mbmorrissey/cadalogger/images/IMG_1785.jpg

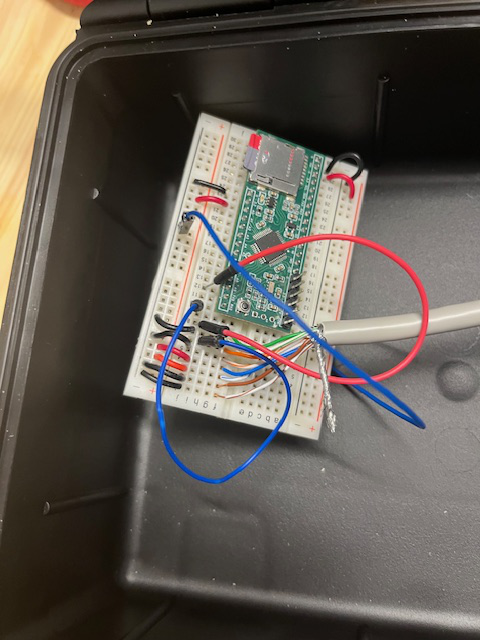
images/IMG_1785.jpg
