mbmorrissey/cadalogger/images/IMG_1795.jpg

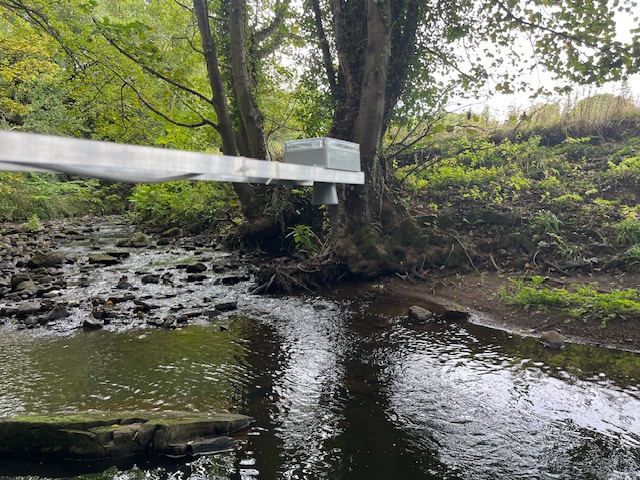
images/IMG_1795.jpg
