mbmorrissey/cadalogger/images/IMG_1796.jpg

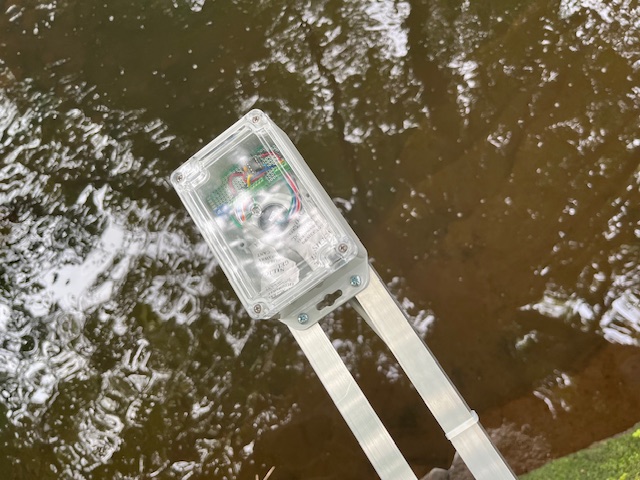
images/IMG_1796.jpg
