mbmorrissey/cadalogger/images/IMG_1797.jpg

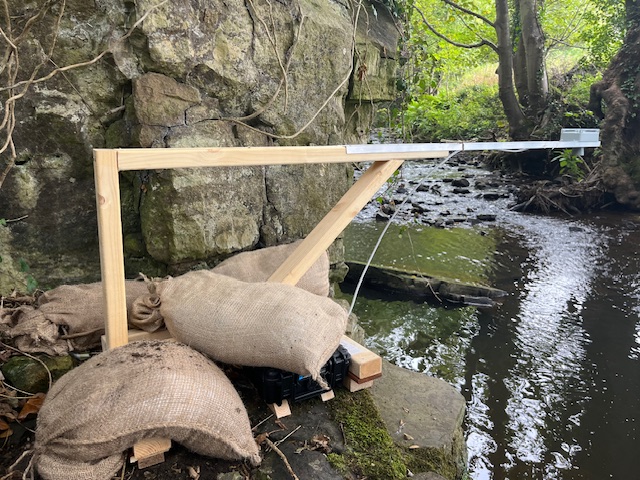
images/IMG_1797.jpg
