mbmorrissey/cadalogger/images/IMG_1801.jpg

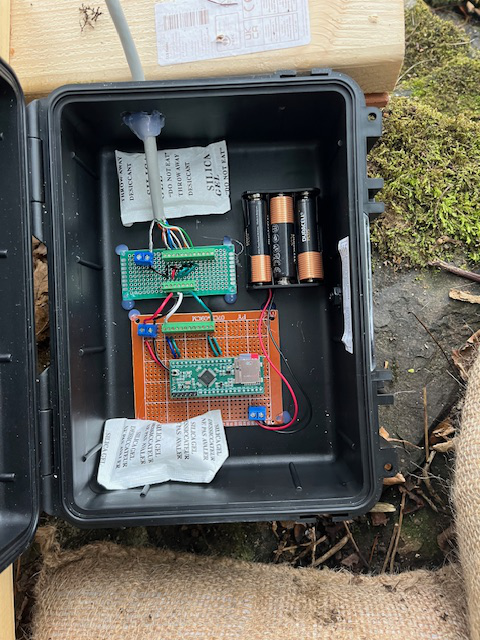
images/IMG_1801.jpg
