mbmorrissey/cadalogger/images/MINI_pinout.png

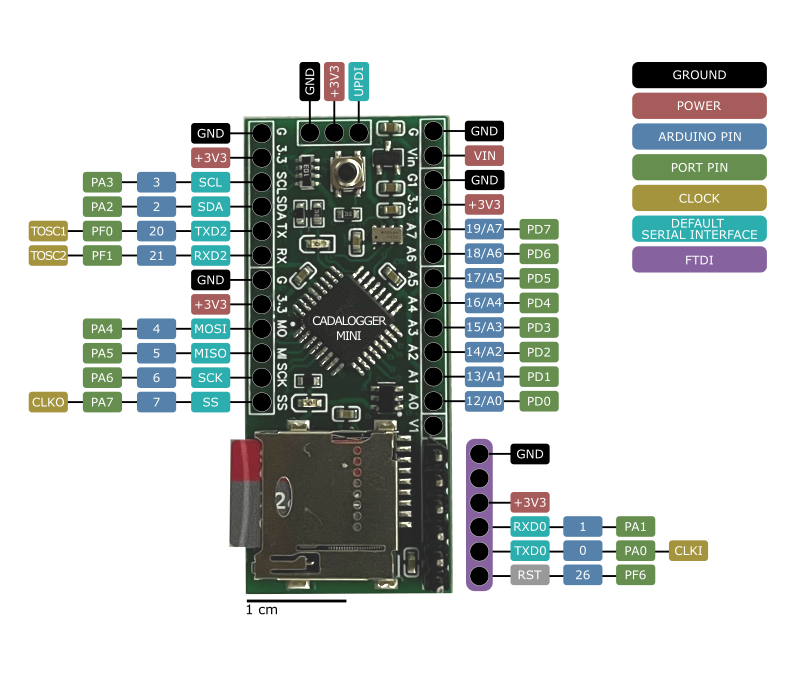
images/MINI_pinout.png
