mbmorrissey/cadalogger/hardware/cadalogger_BOM.xlsx

Sheet: MINI
Item number | Item (short) | Notes | Item (detail) | Manufacturer | Manufacturer part number | Digikey part number | Count | unit cost | quantity for unit cost | total cost per board | quantity for unit cost enough for this many boards | order cost | quantity on hand | on hand sufficient for X boards | Item (copied from column B)
1 | MCU |  | ATMega4808, 32 pin | Microchip | ATMEGA4808-AUR | 150-ATMEGA4808-AURCT-ND | 1 | 1.1968 | 100 | 1.1968 | 100 | 119.68 | 9 | 9 | MCU
2 | RTC |  | RV-3032 | Micro Crystal AG | RV-3032-C7-32.768KHZ-2.5PPM-TA-QC | 2195-RV-3032-C7-32.768KHZ-2.5PPM-TA-QCCT-ND | 1 | 2.6556 | 100 | 2.6556 | 100 | 265.56 | 29 | 29 | RTC
3 | voltage regulator |  | MCP1700, 3.3V | Microchip | MCP1700T-3302E/TT | MCP1700T3302ETTCT-ND | 1 | 0.2984 | 100 | 0.2984 | 100 | 29.84 | 90 | 90 | voltage regulator
4 | uSD clip | Also used in alternate design | MEM2075 | GCT | MEM2075-00-140-01-A | 2073-MEM2075-00-140-01-ACT-ND | 1 | 1.2402 | 100 | 1.2402 | 100 | 124.02 | 60 | 60 | uSD clip
5 | button cell clip |  | 3000TR | Keystone Electronics | 3000TR | 36-3000CT-ND | 1 | 0.5099 | 100 | 0.5099 | 100 | 50.99 | 12 | 12 | button cell clip
6 | switch MOSFET |  | SI2312 | Vishay | SI2312BDS-T1-E3 | SI2312BDS-T1-E3CT-ND | 1 | 0.2947 | 100 | 0.2947 | 100 | 29.47 | 29 | 29 | switch MOSFET
7 | reset switch |  | low profile momentary push button | CIT Relay and Switch | CS1210F260 | 2449-CS1210F260CT-ND | 1 | 0.2932 | 100 | 0.2932 | 100 | 29.32 | 7 | 7 | reset switch
8 | LED | green good for brightness in sunlight |  | SunLED | XZVG53W-8 | 1497-1215-1-ND | 2 | 0.08972 | 500 | 0.17944 | 250 | 44.86 | 160 | 80 | LED
9 | LED resistor | 500R good power-brightness trade-off for green LED | 510R SMD 0603 | Vishay | RCS0603510KFKEA | 41-RCS0603510KFKEACT-ND | 2 | 0.01673 | 1000 | 0.03346 | 500 | 16.73 | 260 | 130 | LED resistor
10 | 10k resistor |  | 10k SMD 0603 | Stackpole | RNCP0603FTD10K0 | RNCP0603FTD10K0CT-ND | 2 | 0.00898 | 1000 | 0.01796 | 500 | 8.98 | 900 | 450 | 10k resistor
11 | 100R resistor |  | 100R SMD 0603 | Stackpole | RMCF0603FT100R | RMCF0603FT100RCT-ND | 1 | 0.0051 | 100 | 0.0051 | 100 | 0.51 | 0 | 0 | 100R resistor
12 | 1 uF capacitor |  | capacitor for voltage regulator | Vishay | VJ0603Y105KXJPW1BC | 720-VJ0603Y105KXJPW1BCCT-ND | 2 | 0.04722 | 500 | 0.09444 | 250 | 23.61 | 80 | 40 | 1 uF capacitor
13 | 0.1 uF capacitor |  | bypass resistors for V pins | Vishay | VJ0603Y104KXXCW1BC | 720-1379-1-ND | 6 | 0.02879 | 1000 | 0.17274 | 166.6666667 | 28.79 | 900 | 150 | 0.1 uF capacitor
14 | resistor array 4x10k |  | 4x10k SMD resistor array 1206 | YAGEO | YC164-JR-0710KL | YC164J-10KCT-ND | 1 | 0.0271 | 100 | 0.0271 | 100 | 2.71 | 0 | 0 | resistor array 4x10k
 | Headers |  |  |  |  |  |  |  |  |  |  |  |  |  | Headers
15 | UPDI header |  | 1x3 pin male, 0.1 in pitch | Wurth Elektronik | 61300311121 | 732-5316-ND | 1 | 0.0573 | 100 | 0.0573 |  |  |  |  | UPDI header
16 | FTDI header |  | 1x6 pin male, 0.1 in pitch | Wurth Elektronik | 61300611121 | 732-5319-ND | 1 | 0.1508 | 100 | 0.1508 |  |  |  |  | FTDI header
17 | header 1 20 pin |  | 1x20 pin male, 0.1 in pitch | Wurth Elektronik | 61302011121 | 732-5329-ND | 1 | 0.5299 | 100 | 0.5299 |  |  |  |  | header 1 20 pin
18 | header 2 12 pin |  | 1x12 pin male, 0.1 in pitch | Wurth Elektronik | 61301211121 | 732-5323-ND | 1 | 0.2468 | 100 | 0.2468 |  |  |  |  | header 2 12 pin
 | Optional items |  |  |  |  |  |  |  |  |  |  |  |  |  | Optional items
19 | FRAM chip |  | 1MBIT FRAM module | Kaga FEI | MB85RC1MTPNF-G-JNERE1 | 865-1268-1-ND | 1 | 4.637 | 10 | 4.637 |  |  | 10 |  | FRAM chip
20 | 0.1 uF capacitor | same as item 13 |  |  |  |  | 1 | 0.02879 | 1000 | 0.02879 |  |  | see above |  | 0.1 uF capacitor
21 | pullup resistor 4.7k | alternatively 10k, but 4.7k appropriate to DS18b20 |  | Stackpole | RMCF0603FT4K70 | RMCF0603FT4K70CT-ND | 2 | 0.00227 | 1000 | 0.00454 |  |  | 0 |  | pullup resistor 4.7k
22 | charge protection resistor | same as item 9 if 500R used there |  |  |  |  | 1 | 0.01673 | 1000 | 0.01673 |  |  | see above |  | charge protection resistor
23 | MOSFET | same as item 6 |  |  |  |  | 1 | 0.2947 | 100 | 0.2947 |  |  | see above |  | MOSFET
24 | 100R resistor | same as item 11 |  |  |  |  | 1 | 0.0051 | 100 | 0.0051 |  |  | see above |  | 100R resistor
25 | 10k resistor | same as item 10; up to two needed, one if no rtc backup required, other pull-down for MOSFET |  |  |  |  | 1 | 0.00898 | 1000 | 0.00898 |  |  | see above |  | 10k resistor
26 | AA battery holder |  | 3 X AA | Keystone Electronics | 2465CN | 36-2465CN-ND | 1 | 1.7232 | 25 | 1.7232 |  |  | 5 |  | AA battery holder
NOTES |  |  |  |  |  |  |  |  | total cost - bare board
These headers seem on the expensive side |  |  |  |  |  |  |  |  | total component cost of | 7.01904 | GBP per board
 |  |  |  |  |  |  |  |  | for the manufactor of min | 100 | boards (errors notwithstanding)
 |  |  |  |  |  |  |  |  | up-front cost
 |  |  |  |  |  |  |  |  | sufficient components for | 100 | boards
 |  |  |  |  |  |  |  |  | requires a component order costing | 775.07 | GBP

Sheet: MAXI
Item number | Item (short) | Notes | Item (detail) | Manufacturer | Manufacturer part number | Digikey part number | Count | unit cost | quantity for unit cost | total cost per board | quantity for unit cost enough for this many boards | order cost | quantity on hand | on hand sufficient for X boards | Item (copied from column B)
1 | MCU |  | ATMEGA4809, 40 pin | Microchip Technology | ATMEGA4809-PF | ATMEGA4809-PF-ND | 1 | 2.2243 | 100 | 2.2243 | 100 | 222.43 | 5 | 5 | MCU
2 | RTC |  | DS3231 | Maxim Integrated | DS3231M+ | DS3231M+-ND | 1 | 6.417 | 100 | 6.417 | 100 | 641.7 | 1 | 1 | RTC
3 | voltage regulator |  | MCP1700, 3.3V | Microchip Technology | MCP1700-3302E/TO | MCP1700-3302E/TO-ND | 1 | 0.2984 | 100 | 0.2984 | 100 | 29.84 | 3 | 3 | voltage regulator
4 | uSD clip |  | MEM2075 | GCT | MEM2075-00-140-01-A | 2073-MEM2075-00-140-01-ACT-ND | 1 | 1.2402 | 100 | 1.2402 | 100 | 124.02 | 60 | 60 | uSD clip
5 | button cell clip |  | 3001, for CR1220 | Keystone Electronics | 3001 | 36-3001-ND | 1 | 0.2517 | 100 | 0.2517 | 100 | 25.17 | 0 | 0 | button cell clip
6 | power switch |  | TPS2021 | Texas Instruments | TPS2021P | 296-34582-5-ND | 1 | 1.5394 | 100 | 1.5394 | 100 | 153.94 | 13 | 13 | power switch
7 | reset switch | tactile switch | 1825910 | TE Connectivity ALCOSWITCH Switches | 1825910-6 | 450-1650-ND | 1 | 0.0869 | 100 | 0.0869 | 100 | 8.69 | 10 | 10 | reset switch
8 | LED | green good for brightness in sunlight | Green, 3mm Dia | Würth Elektronik | 151034GS03000 | 732-11402-ND | 2 | 0.0984 | 500 | 0.1968 | 250 | 49.2 | 94 red | 47 | LED
9 | LED resistor | 500R good power-brightness trade-off for green LED | 510 OHM 5% | Stackpole Electronics Inc | CF18JT510R | CF18JT510RCT-ND | 2 | 0.00669 | 1000 | 0.01338 | 500 | 6.69 | 25 470 Ohm | 12.5 | LED resistor
10 | 10 kOhm resistor |  | 10K OHM 1% | Stackpole Electronics Inc | RNF14FTD10K0 | RNF14FTD10K0CT-ND | 6 | 0.01254 | 1000 | 0.07524 | 166.6666667 | 12.54 | 100+ | 16.66666667 | 10 kOhm resistor
11 | 1.0 uF capacitor | for voltage regulator | 1 µF ±10% 50V | KEMET | C330C105K5R5TA | 399-4389-ND | 2 | 0.09995 | 1000 | 0.1999 | 500 | 99.95 | 45+ | 22.5 | 1.0 uF capacitor
12 | 0.1 uF capacitor | for V+ pins | 0.1 µF ±10% 50V | Vishay Beyschlag | K104K15X7RF5TH5 | BC1101CT-ND | 8 | 0.04533 | 1000 | 0.36264 | 125 | 45.33 | 30+ | 3.75 | 0.1 uF capacitor
 | Headers
13 | UPDI header |  | 1x3 pin male, 0.1 in pitch | Wurth Elektronik | 61300311121 | 732-5316-ND | 1 | 0.0573 | 100 | 0.0573 | 100 | 5.73 |  |  | UPDI header
14 | FTDI header |  | 1x6 pin male, 0.1 in pitch | Wurth Elektronik | 61300611121 | 732-5319-ND | 1 | 0.1508 | 100 | 0.1508 | 100 | 15.08 |  |  | FTDI header
15 | header 1, 15 pin |  | 1x15 pin female, 0.1 in pitch | Sullins Connector Solutions | PPPC151LFBN-RC | S7048-ND | 1 | 0.50825 | 440 | 0.50825 | 440 | 223.63 |  |  | header 1, 15 pin
16 | header 2, 9 pin |  | 1x9 pin female, 0.1 in pitch | Sullins Connector Solutions | PPPC091LFBN-RC | S7042-ND | 1 | 0.33448 | 440 | 0.33448 | 440 | 147.1712 |  |  | header 2, 9 pin
17 | header 3, 4 pin |  | 1x4 pin female, 0.1 in pitch | Sullins Connector Solutions | PPPC041LFBN-RC | S7037-ND | 1 | 0.2704 | 100 | 0.2704 | 100 | 27.04 |  |  | header 3, 4 pin
 | Optional items
18 | wire to board |  | 2 positions, terminal block | Phoenix Contact | 1935161 | 277-1667-ND | 1 | 0.30395 | 250 | 0.30395 | 250 | 75.9875 |  |  | wire to board
19 | socket 1, 40 pin | for reuse of MCU | 2x20 socket | CNC Tech | 243-40-1-06 | 1175-1481-ND | 1 | 0.4309 | 100 | 0.4309 | 100 | 43.09 | 8
20 | socket 2, 8 pin | for reuse of the power switch | 2x4 socket | Assmann WSW Components | A 08-LC-TT | AE9986-ND | 1 | 0.0974 | 100 | 0.0974 | 100 | 9.74 | 1
21 | AA battery holder |  | 3 X AA | Keystone Electronics | 2465CN | 36-2465CN-ND | 1 | 1.7232 | 25 | 1.7232 | 25 | 43.08 | 5 |  | AA battery holder
 |  |  |  |  |  |  |  |  | total cost - bare board
 |  |  |  |  |  |  |  |  | total component cost of | 12.90586 | GBP per board
 |  |  |  |  |  |  |  |  | for the manufactor of min | 100 | boards (errors notwithstanding)
 |  |  |  |  |  |  |  |  | up-front cost
 |  |  |  |  |  |  |  |  | sufficient components for | 100 | boards
 |  |  |  |  |  |  |  |  | requires a component order costing | 1419.5 | GBP
