mbmorrissey/cadalogger/hardware/Schematic_CadaloggerMICKEY_2025-10-12.pdf

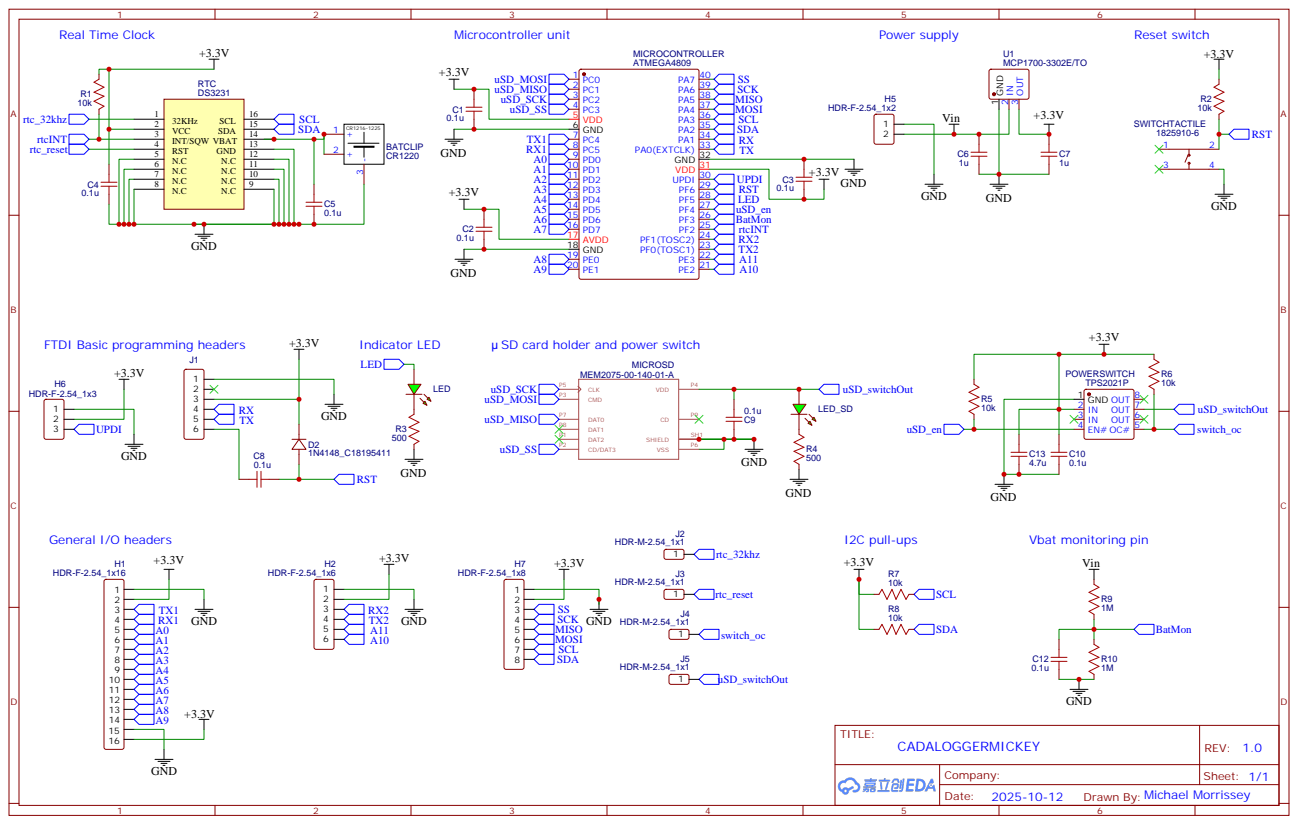
[picture p14: page 1]

FTDI Basic programming headers

SD card holder and power switch
