mbmorrissey/cadalogger/hardware/Schematic_CadaloggerMINI_2025-10-12.pdf

## Power supply

Real Time Clock | Microcontroller unit | Reset switch

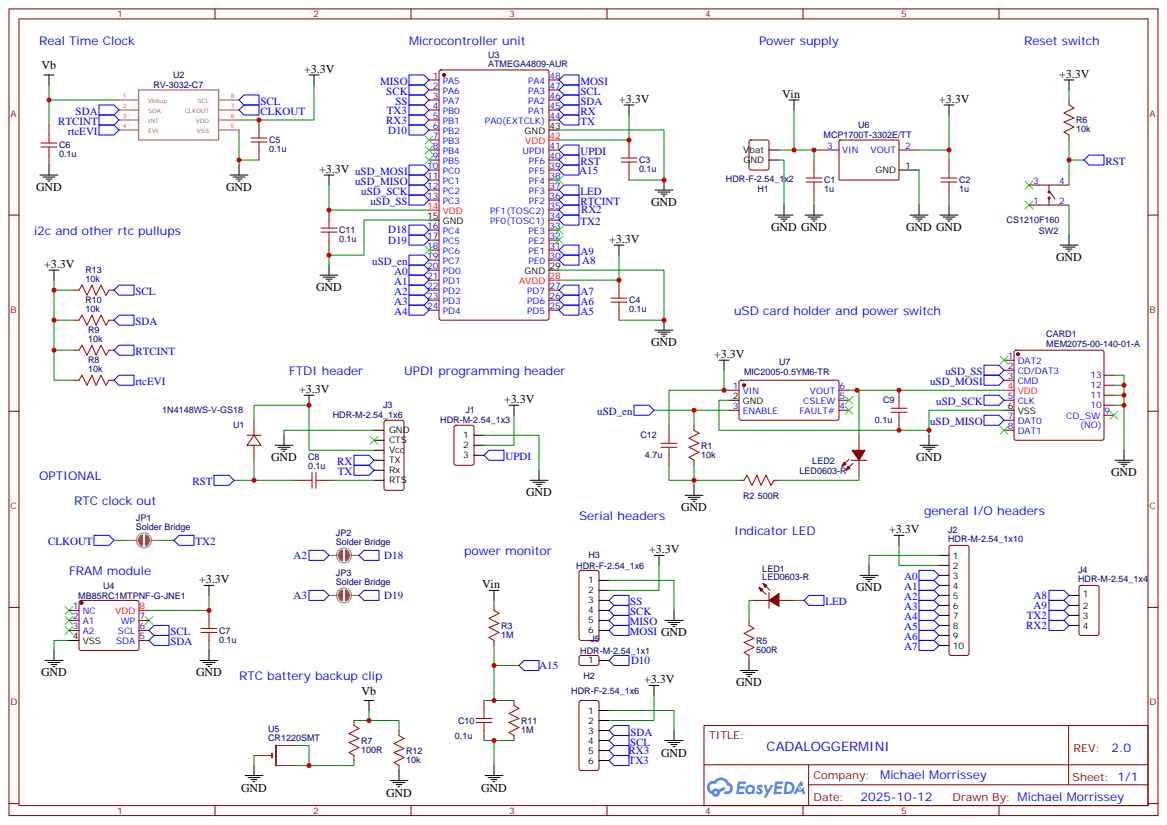
[picture p15: page 1]

i2c and other rtc pullups

uSD card holder and power switch

GND
RTC battery backup clip

Drawn By: Michael Morrissey
