mbmorrissey/cadalogger/images/stream_stage_power_profile.pdf

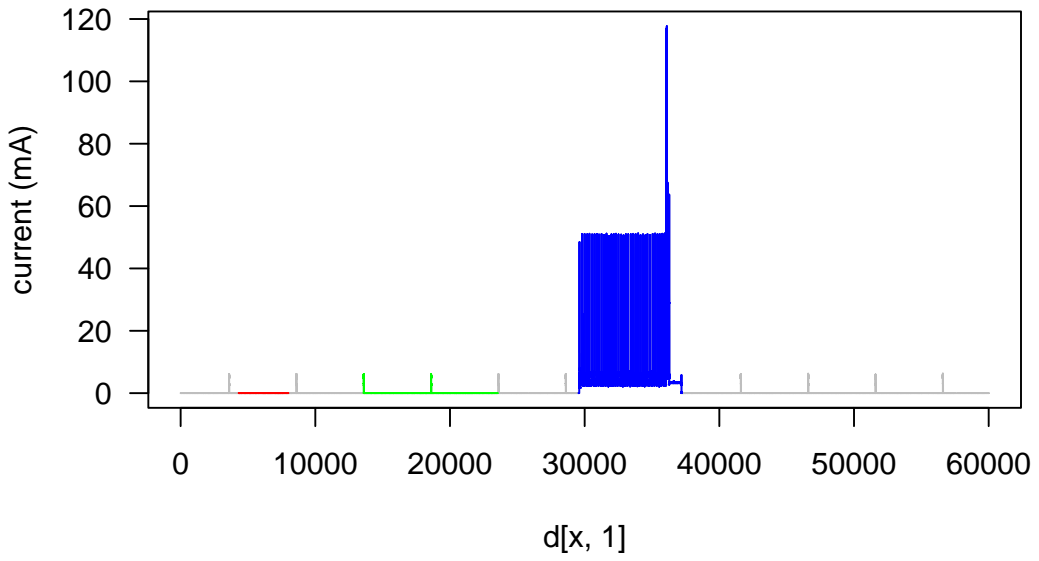
[picture p16: page 1]
current (mA)
