mbmorrissey/cadalogger/(commit log)

2023-03-15 add schematic
2023-04-29 first attempt at custom board definition
2023-04-29 attempt at custom board definition
2023-05-19 updated for new mini board design
2023-05-25 MAXI example
    measuring temperature, humidity, soil moisture, light conditions on MAXI
2023-05-25 Power Consumption
    Power Consumption of MAXI while reading temperature, humidity, soil moisture, light every minute. Resting = 445 µA; Reading sensors and writing to µSD card: 119 mA.
2023-05-26 update .h and .cpp for MAXI
    update .h and .cpp for MAXI, add example code for reading temperature, humidity, and light.
2023-05-29 add rtc temperature and watchdog functions
2023-06-05 update ds3231 functions
    added 8 second heartbeat and reading temperature from RTC
2023-06-08 Update micro-environmental condition example
    pin power CHIRP moisture sensor
2023-06-08 update cadalogger.cpp
    low to falling for interrupt
2023-06-09 updated rtc temperature function
2023-10-06 update files in hardware directory
    [cadalogger_BOM.xlsx]
2025-10-12 updating gerber files
2026-11-05 add stream stage example file
2026-11-05 Update README with stream stage figure
2026-11-05 add iridium power profile
